Hieuht2000/BLE-device-for-environment-sensing/README.md

# Embedded-Systems-project-course

In this project, I had made a small bluetooth device to monitoring environment sensing like: Sound loudness, temperature, humidity, pressure, air quality...
After that, a rasperry pi 4B was used as a BLE gateway to receive data from the device and using MQTT to publish and vizualize the data using Node-Red.

## Project overview:



## IoT device setup:

In this setup, we will make a smal device serve as an IoT sensor, actually an array of sensors. The XIAO nrf52840 MCU , comes with the powerful nRF52840 processor from Nordic Semiconductors, a 32-bit ARM Cortex-M4 CPU running at 64 MHz, 1MB of CPU Flash Memory, 256KB of SRAM, and a Bluetooth 5 low energy module.The device also contains an array of embedded sensors:
* Grove Analog microphone to monitoring sound loudness

* BME680 Adafruit sensor for relative humidity, temperature, barometer, gas resistance.

* SW 520D tilt sensor for detect if the device been moved.

* Lithium battery to power the device.

 316613222_531629095508170_2519224450054969624_n
## Previewing and Debugging BLE Device Services

Before looking at the code running on the Raspberry Pi, I use  nRF Connect for Mobiles to preview and debug the Environmental Sensing service running on the device and being advertised over BLE.



## IoT gateway setup:

In this post, I will use a recent generation Raspberry Pi 4 Model B single-board computer (SBC), to serve as an IoT Gateway. The device will transmit IoT sensor telemetry, over BLE, to the Raspberry Pi. The Raspberry Pi, using Wi-Fi or Ethernet, is then able to securely transmit the sensor telemetry data to the Cloud. In Bluetooth terminology, the Bluetooth Peripheral device (aka GATT Server), which is our device, will transmit data to the Bluetooth Central device (aka GATT Client), which is the Raspberry Pi.

* BLE Client Python Code
To act as the BLE Client (aka central device), the Raspberry Pi runs a Python script. The script,  `gateway.py`, uses the bluepy Python module for interfacing with BLE devices through Bluez, on Raspberry Pi OS.

316130815_839430733934008_3642109668385598030_n

## Node-Red Dashboard:

* Preview:





## Update incoming:
-Real PCB

-Node Red Dashboard
