Hieuht2000/BLE-device-for-environment-sensing/3D.PNG

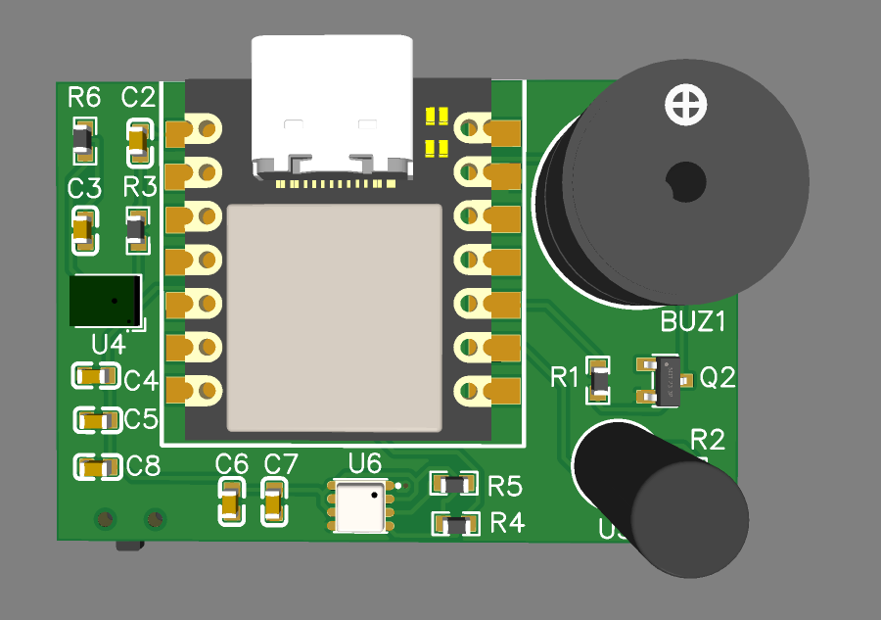
3D.PNG
