Hieuht2000/BLE-device-for-environment-sensing/Schematic_feather_2022-11-29.pdf

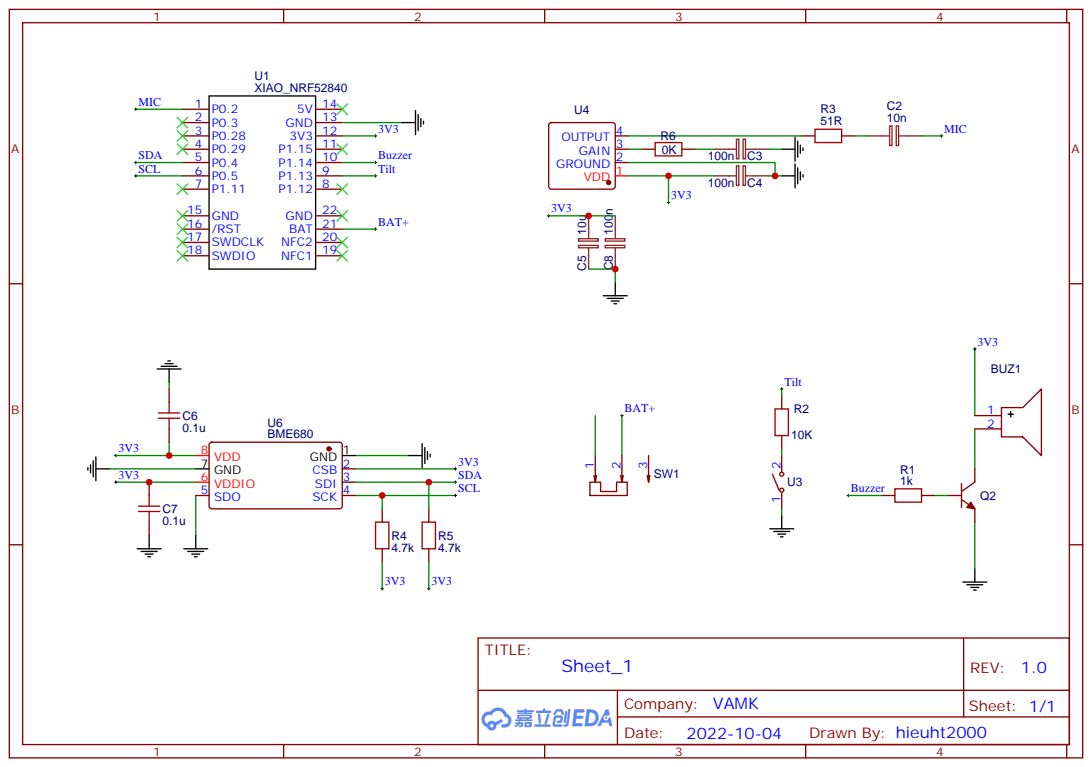
[picture p17: page 1]
