Hieuht2000/BLE-device-for-environment-sensing/(commit log)

2022-11-24 Add files via upload
    Main Arduino sketch for device.
2022-11-24 Add files via upload
    Gerber file
2022-11-24 Create Schematic
2022-11-29 Create PCB
